guidoglorioso/StreamDeck-PCB/README.md

# StreamDeck-PCB
Proyecto de PCB para la materia de IDCI. El proyecto consta en una stream deck que da la posibilidad al usuario de crear shortcuts y macros personalizadas.
