guidoglorioso/StreamDeck-PCB/3d models/KEYCAP.STEP

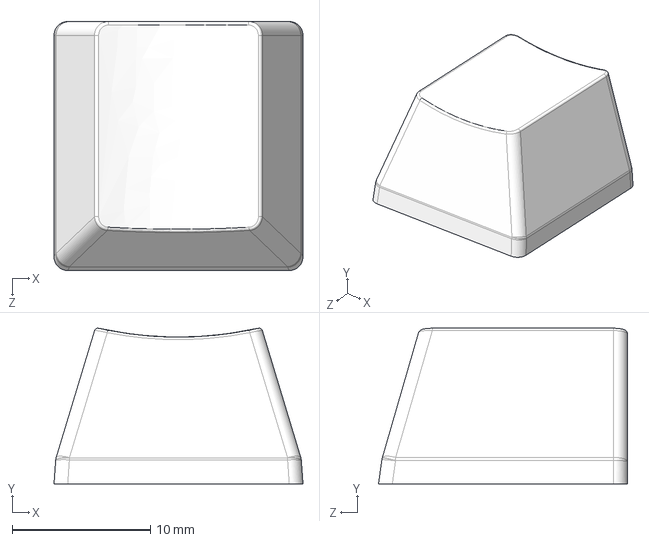
[picture p35: CAD file, 2024-10-15]
3d models/KEYCAP.STEP
18.0 x 11.3 x 18.0 mm
