guidoglorioso/StreamDeck-PCB/3d models/Volume Knob 32x13x6mm.STEP

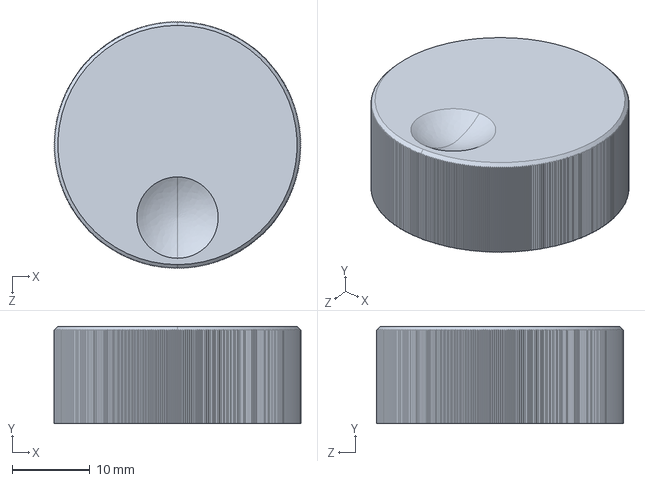
[picture p36: CAD file, 2024-10-15]
3d models/Volume Knob 32x13x6mm.STEP
31.8 x 12.5 x 31.8 mm
