guidoglorioso/StreamDeck-PCB/3d models/Bateria LiPo 3.7V.STEP

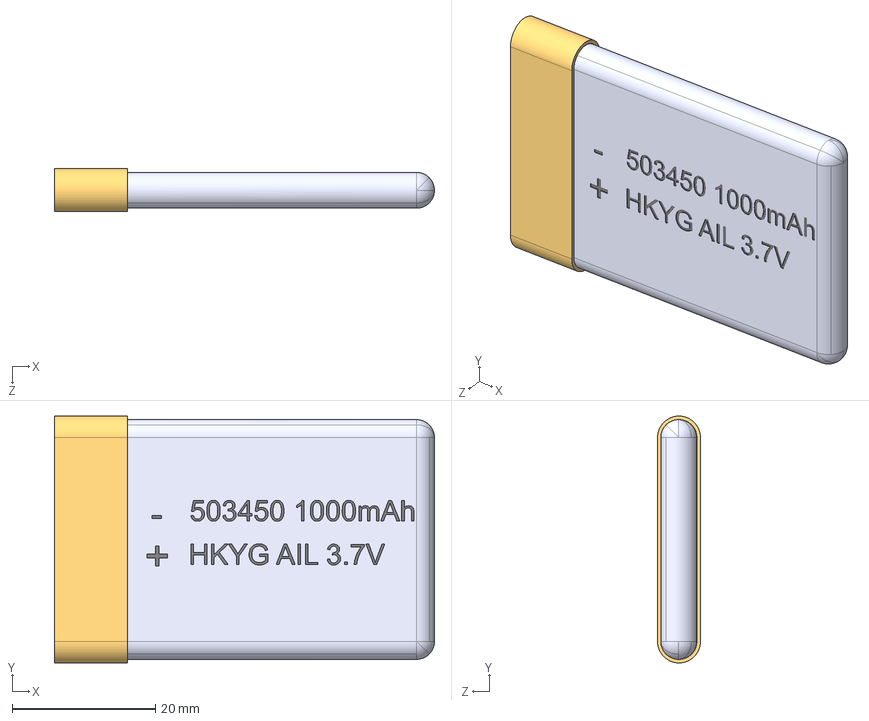
[picture p37: CAD file, 2024-10-08]
3d models/Bateria LiPo 3.7V.STEP
53.1 x 34.5 x 6.00 mm
parte de la pila_lipo.step
Bateria LiPo 3.7V 1000mA 503450.step
Bateria LiPo 3.7V 1000mA 503450-0.step
Bateria LiPo 3.7V 1000mA 503450-1.step
