guidoglorioso/StreamDeck-PCB/3d models/Kailh Polia.step

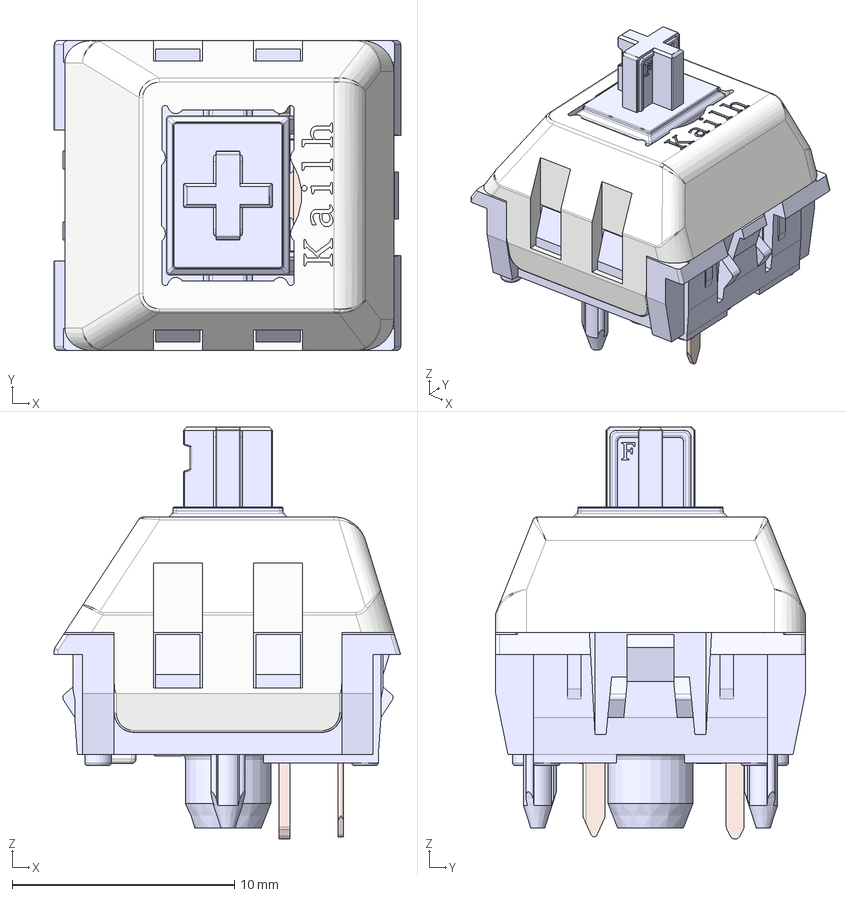
[picture p38: CAD file, 2024-10-08]
3d models/Kailh Polia.step
15.6 x 14.0 x 18.5 mm
Housing
ThickContact
SpringContact
Stem
Lid
