guidoglorioso/StreamDeck-PCB/3d models/EG2315.stp

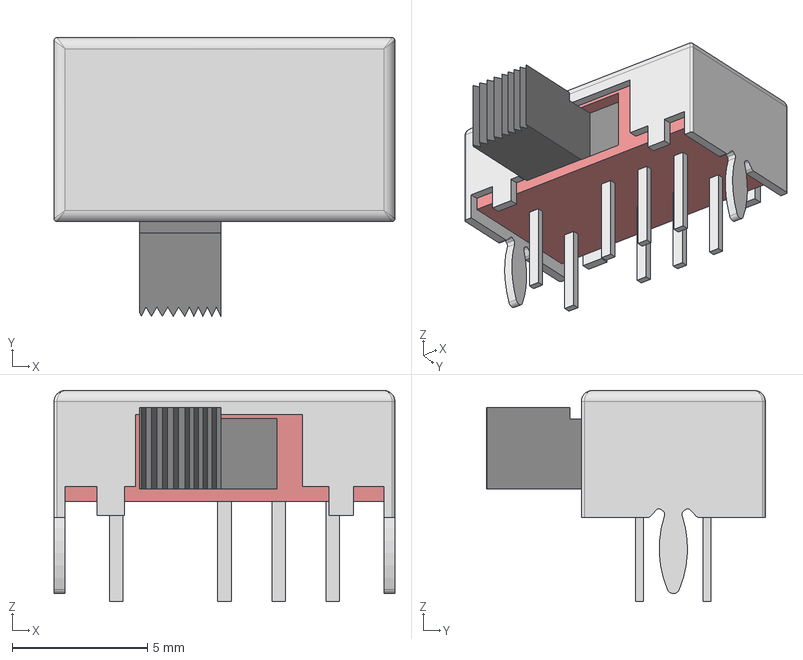
[picture p39: CAD file, 2024-10-08]
3d models/EG2315.stp
12.6 x 10.3 x 7.80 mm
