guidoglorioso/StreamDeck-PCB/3d models/ER-OLED0.91-3.STEP

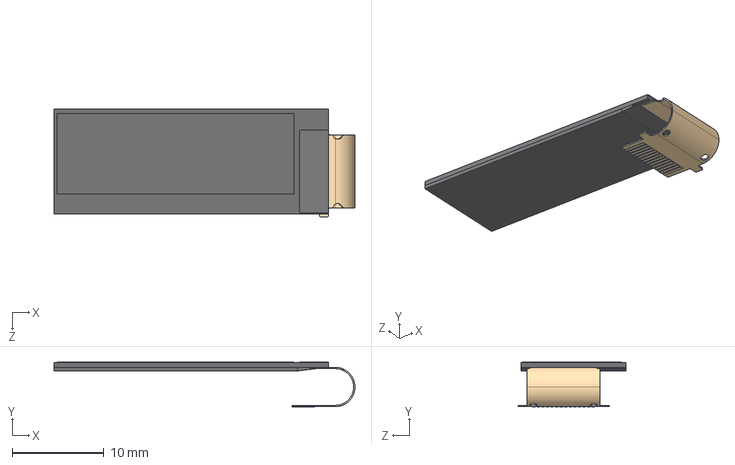
[picture p40: CAD file, 2024-10-08]
3d models/ER-OLED0.91-3.STEP
32.9 x 4.88 x 11.9 mm
