guidoglorioso/StreamDeck-PCB/Docs/SPEC-KS-9H10B045NN-Y51__Rev-1_KS-9_G_Red_Pro_3.0_Switch.pdf

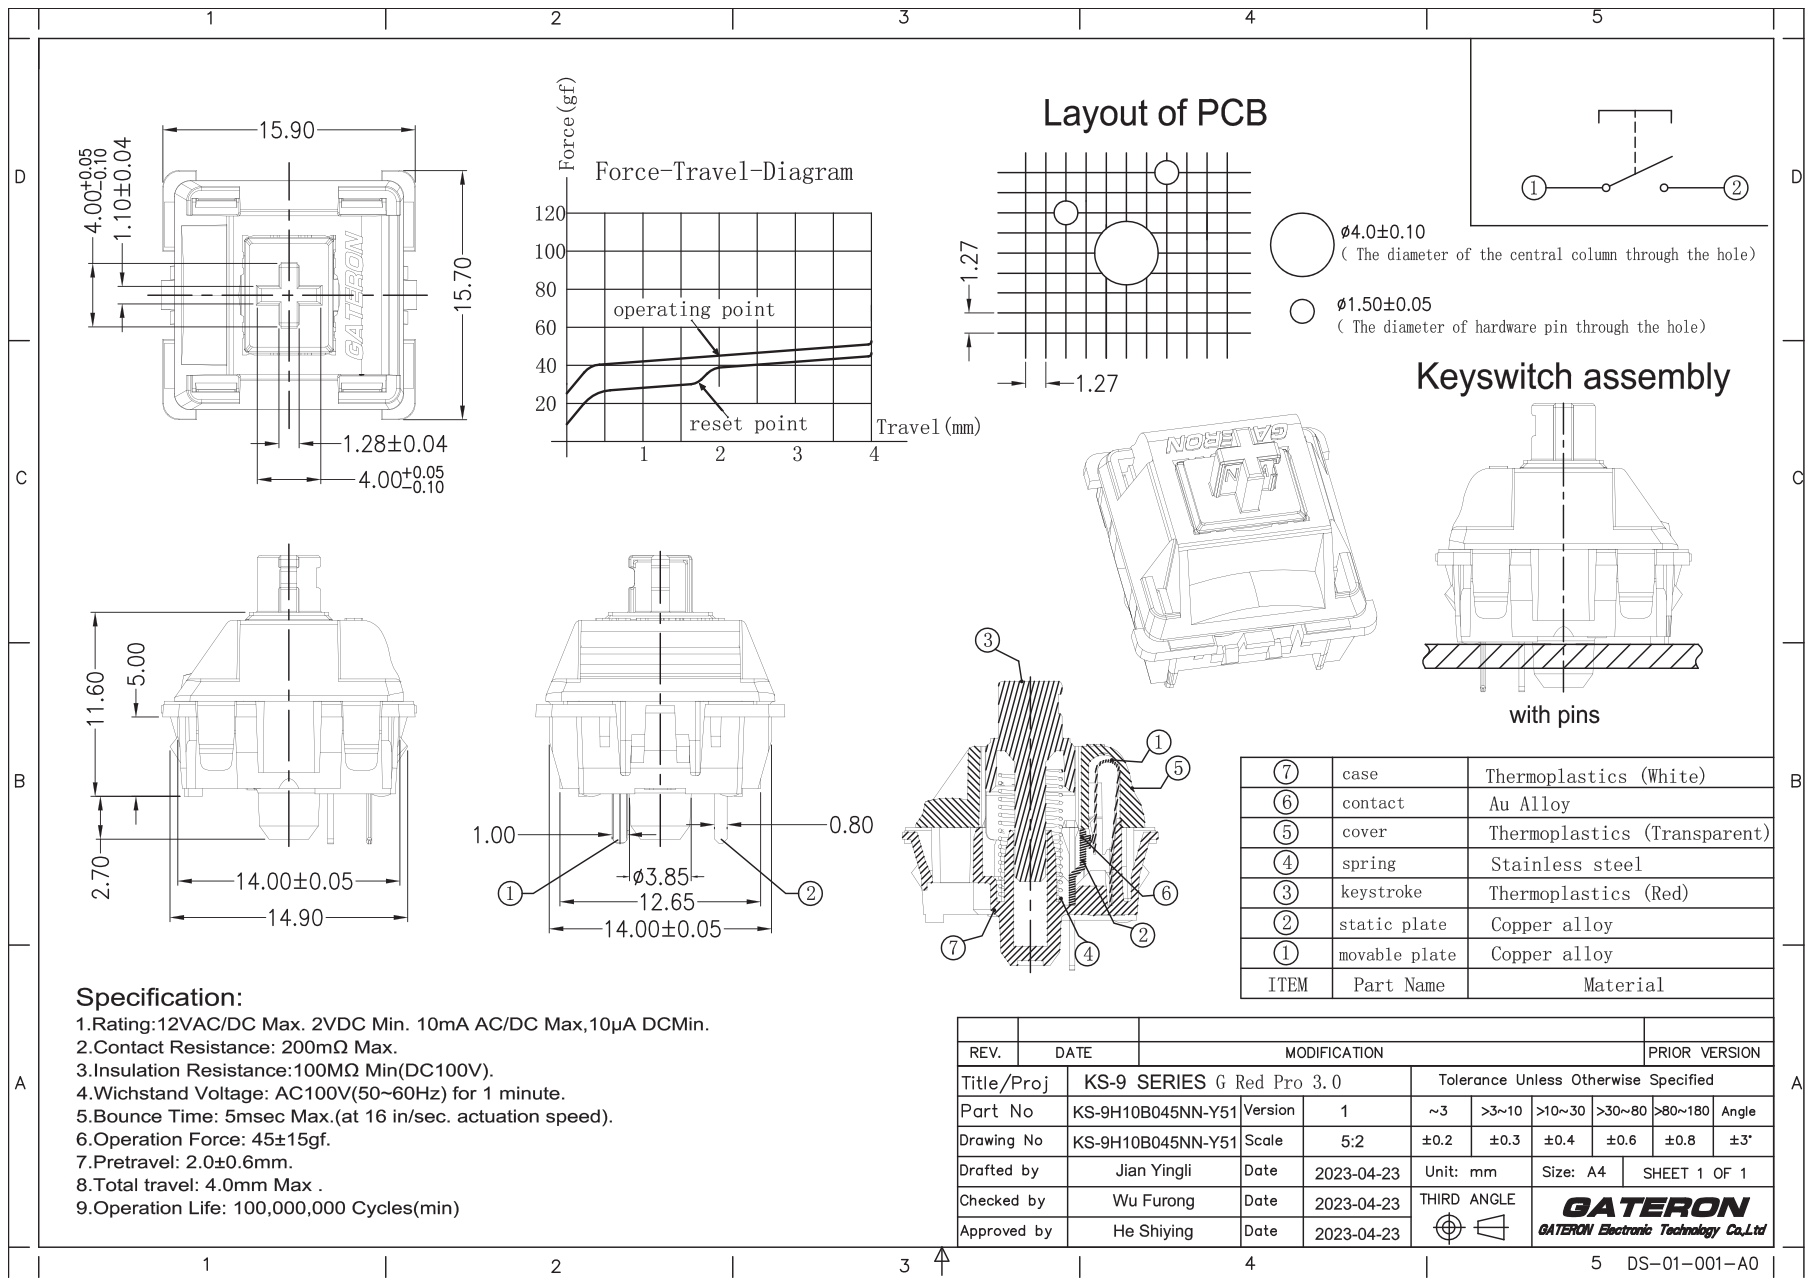
[picture p41: page 1]

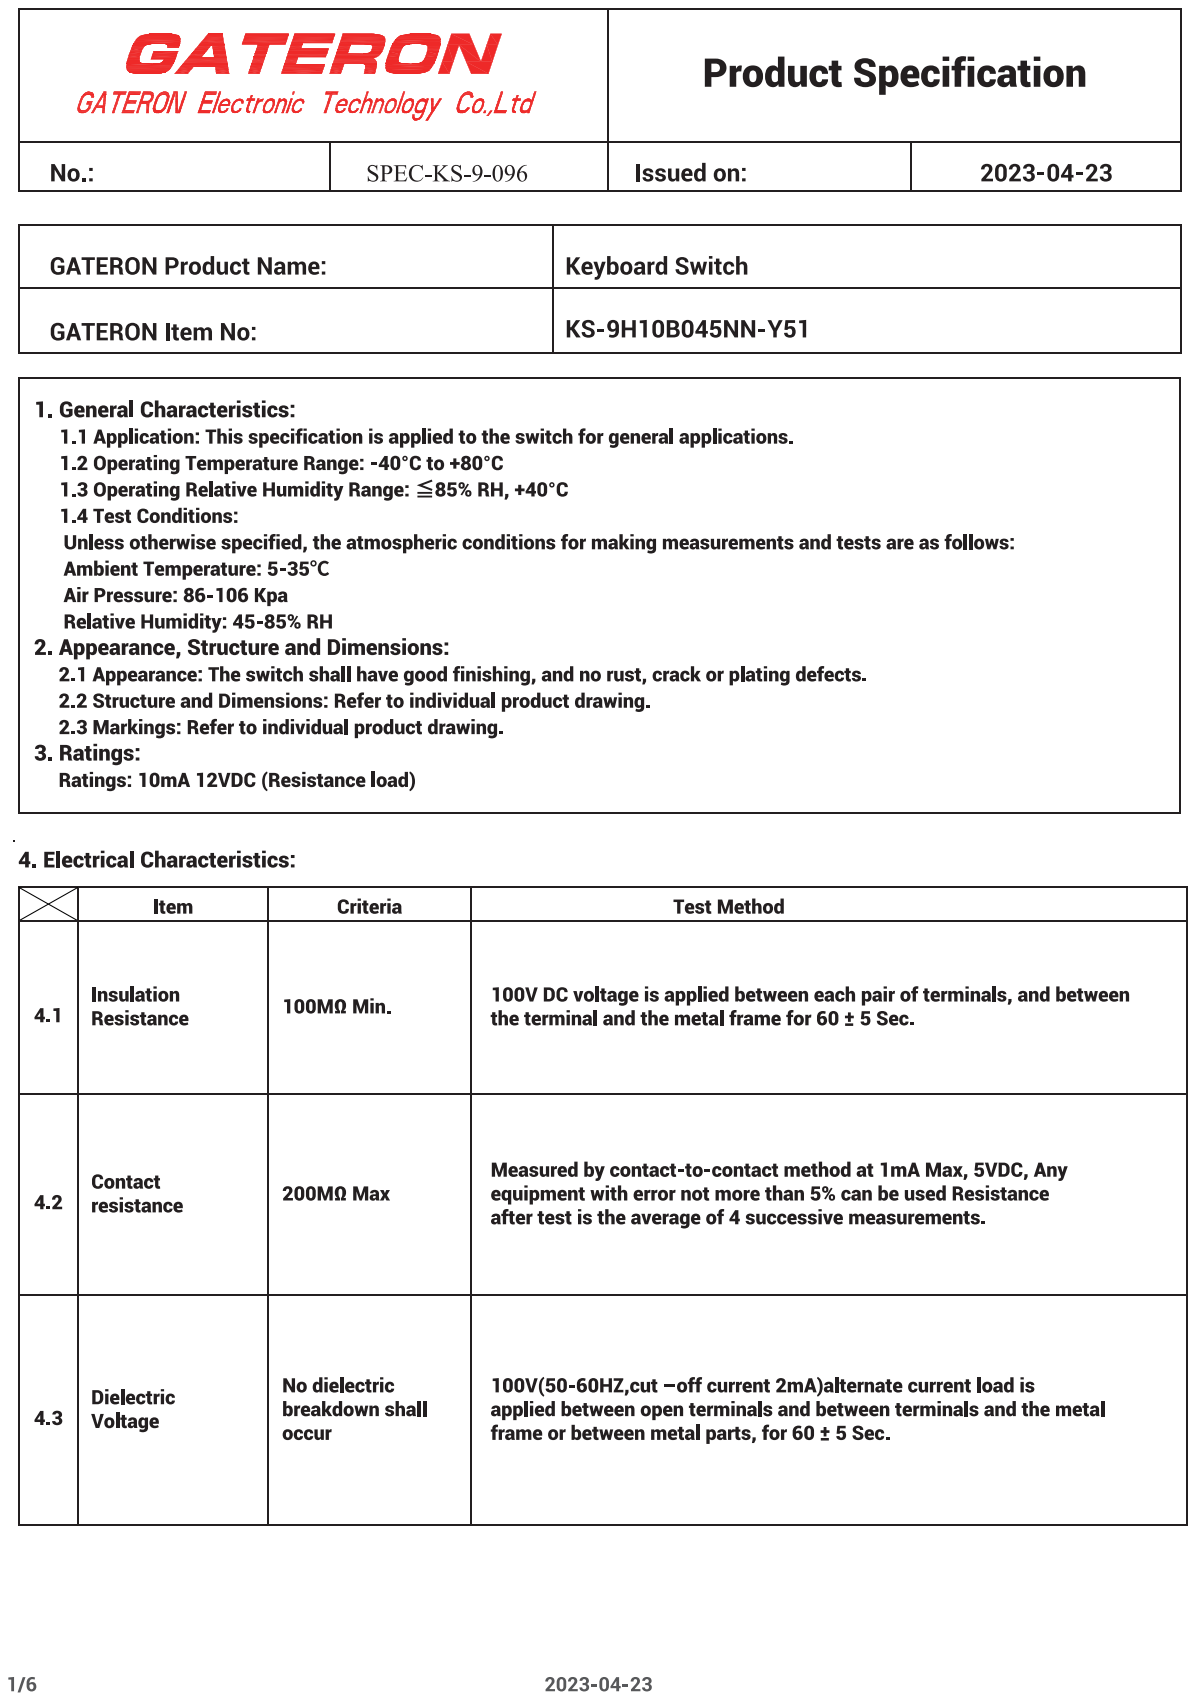
[picture p42: page 2]

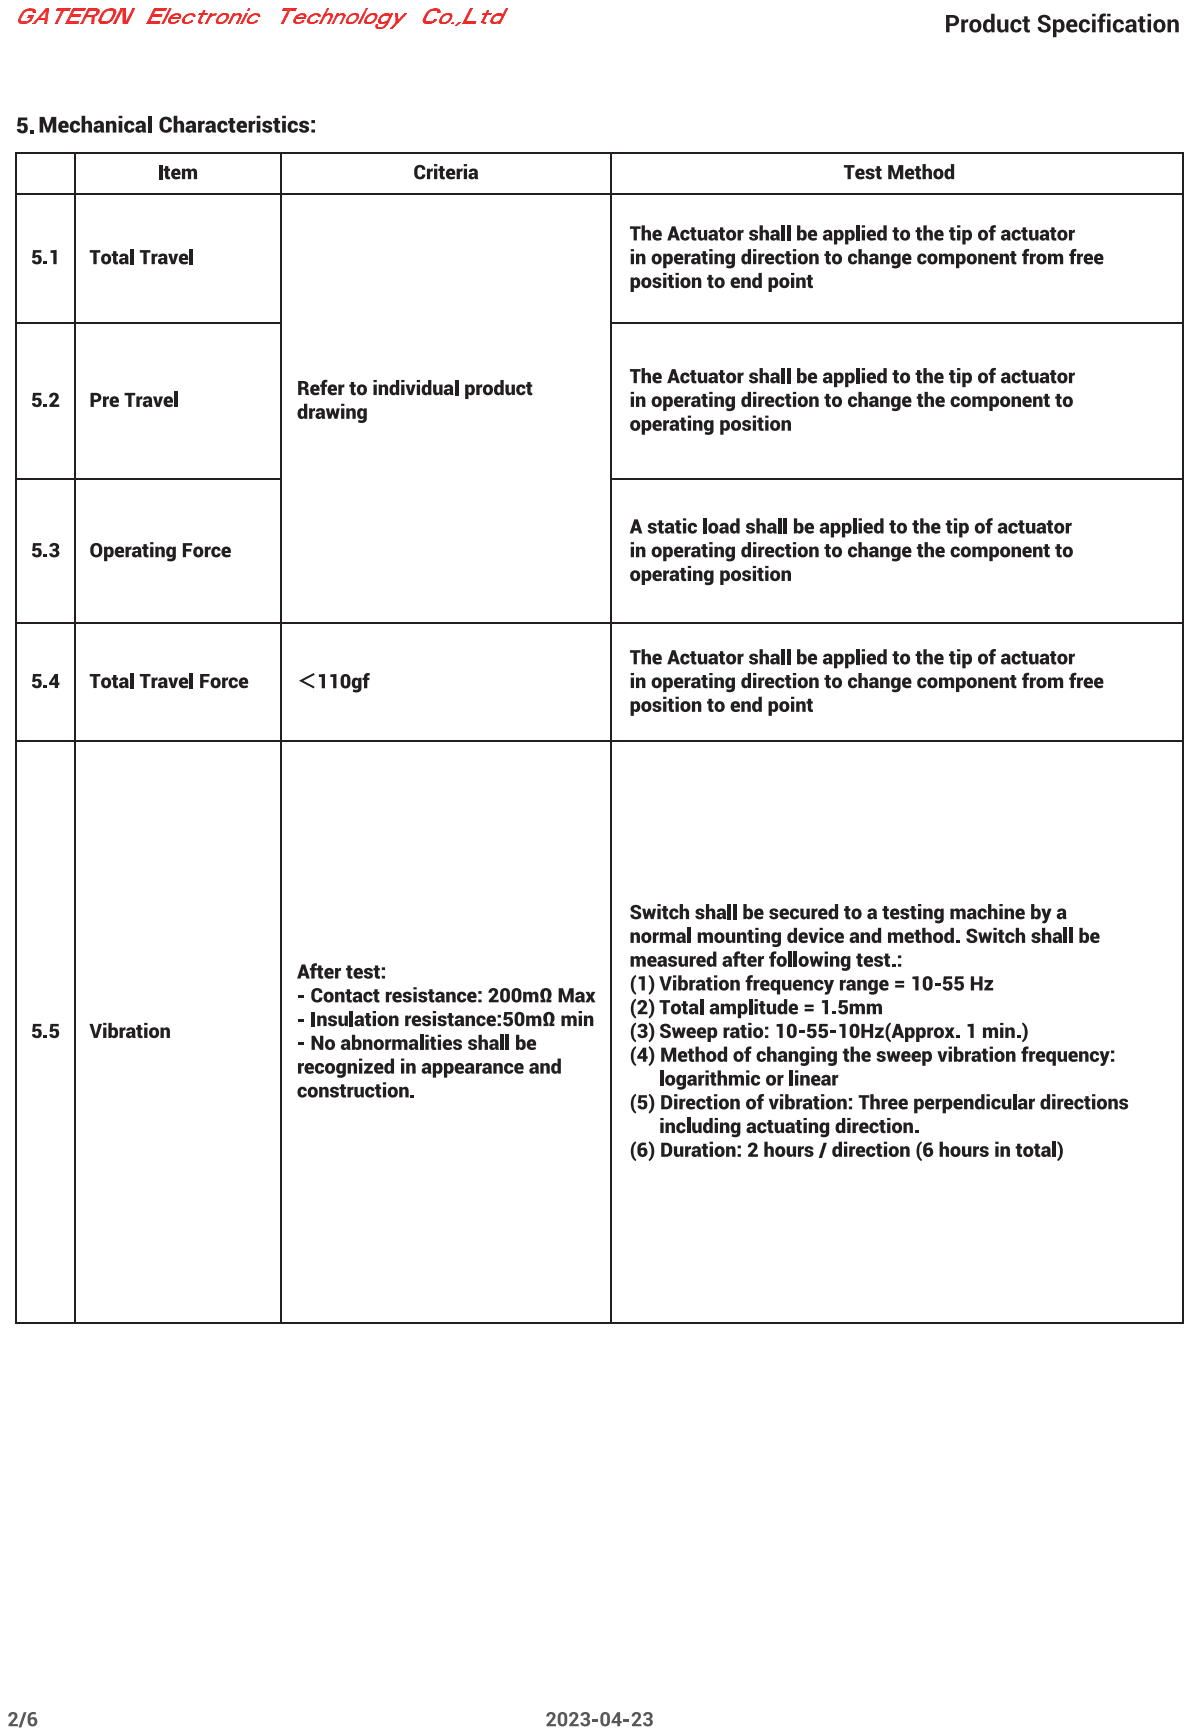
[picture p43: page 3]

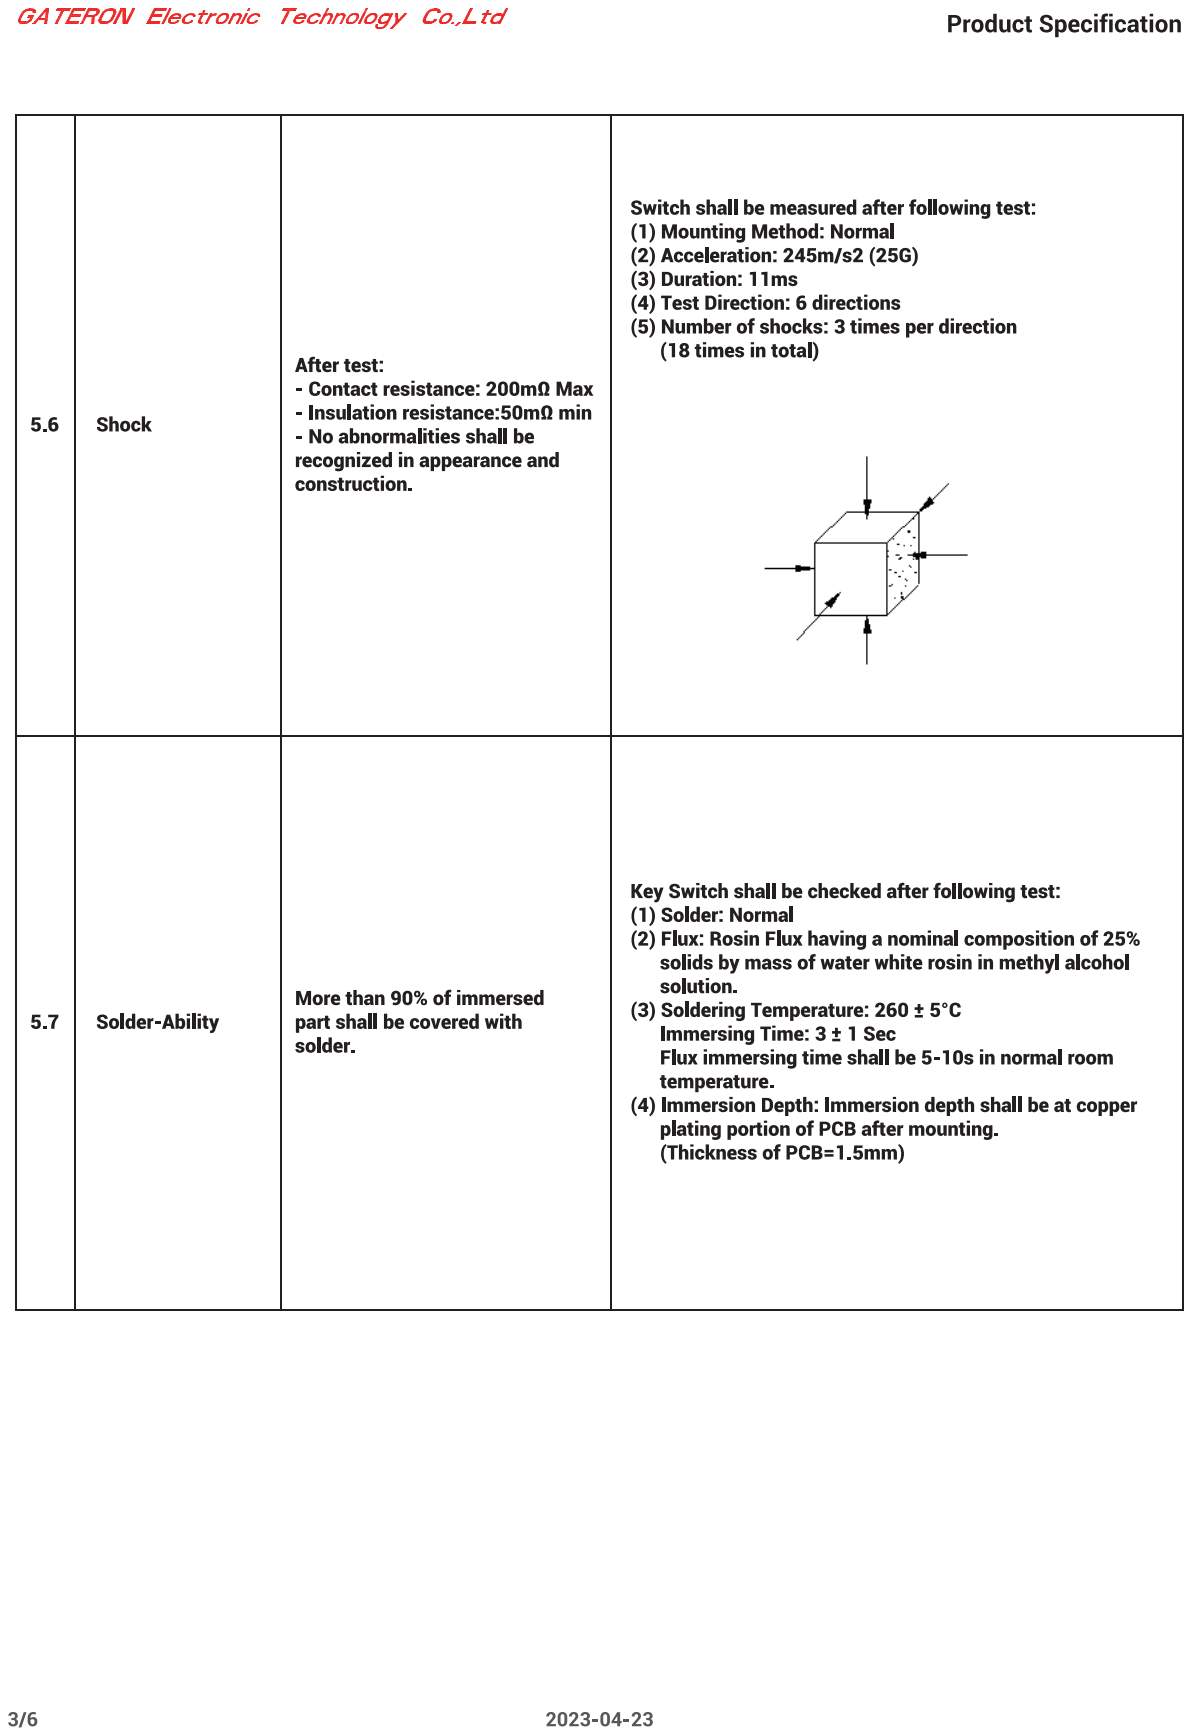
[picture p44: page 4]

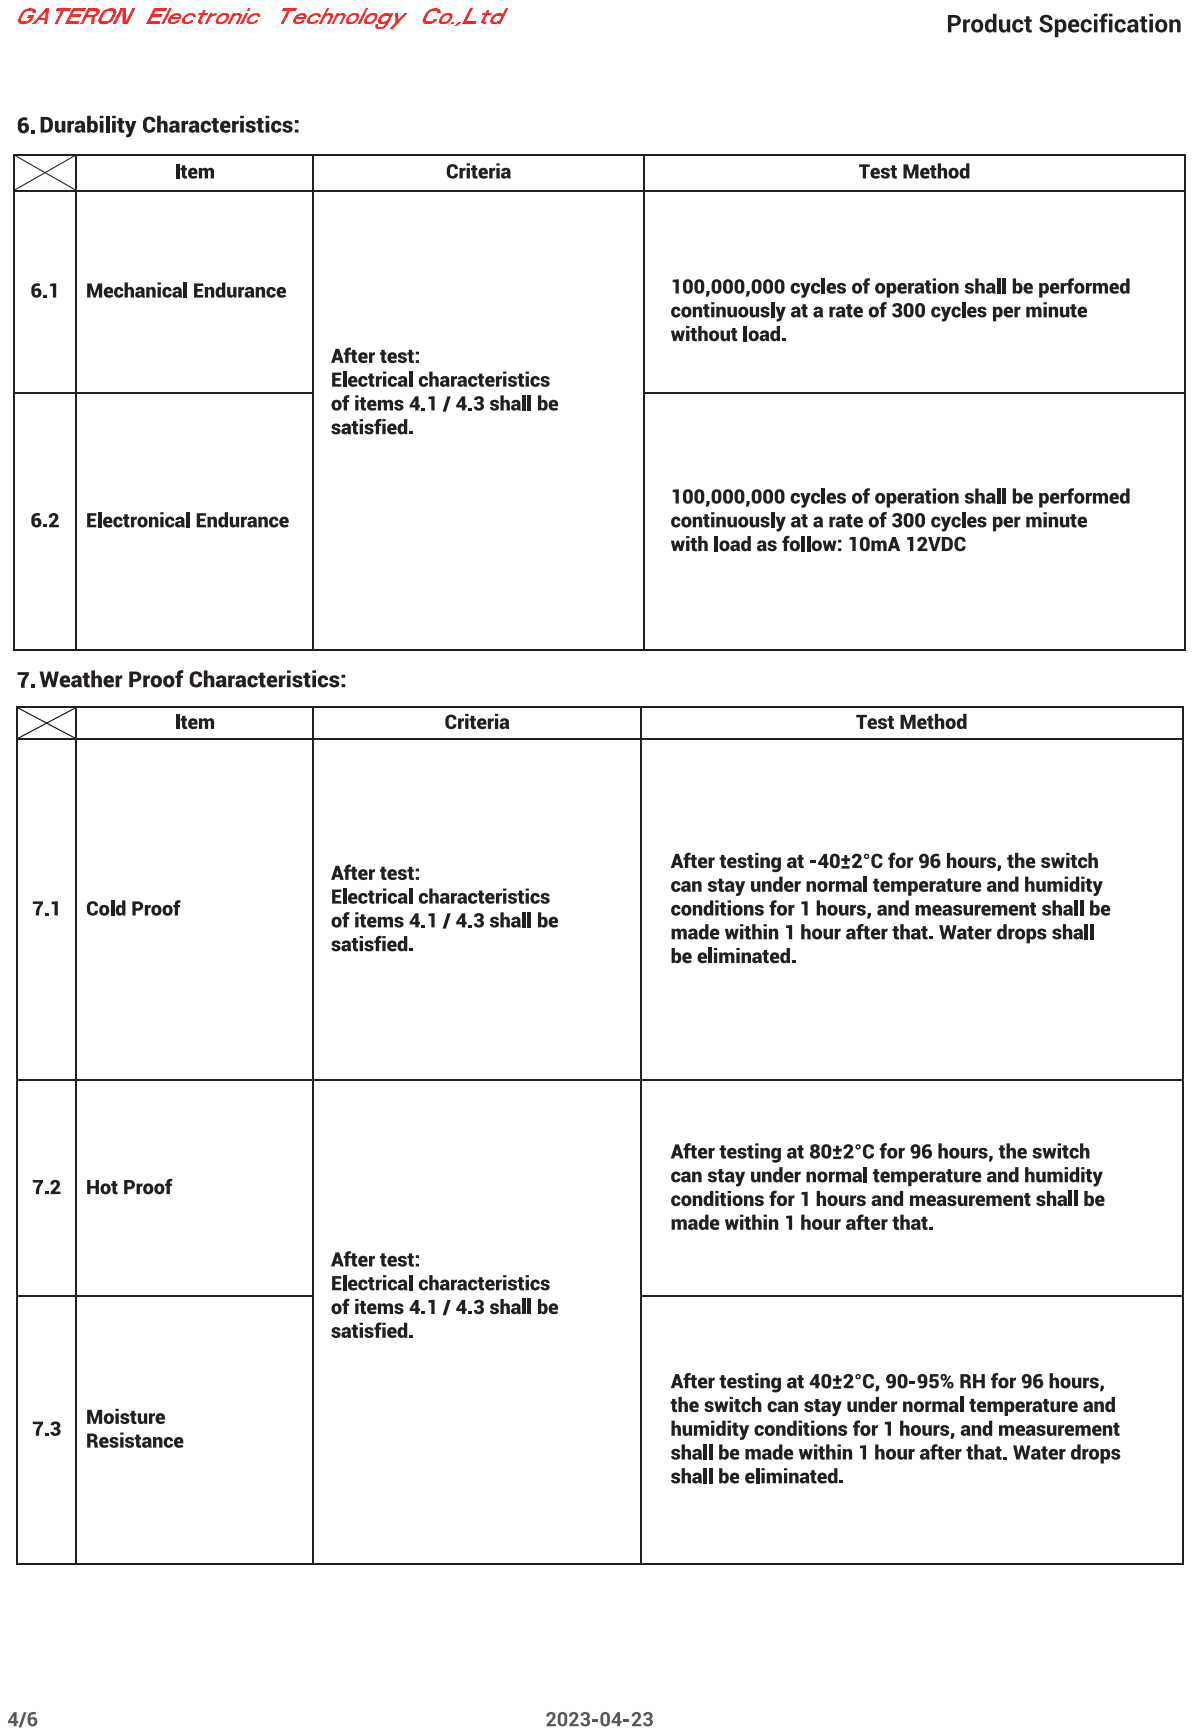
[picture p45: page 5]

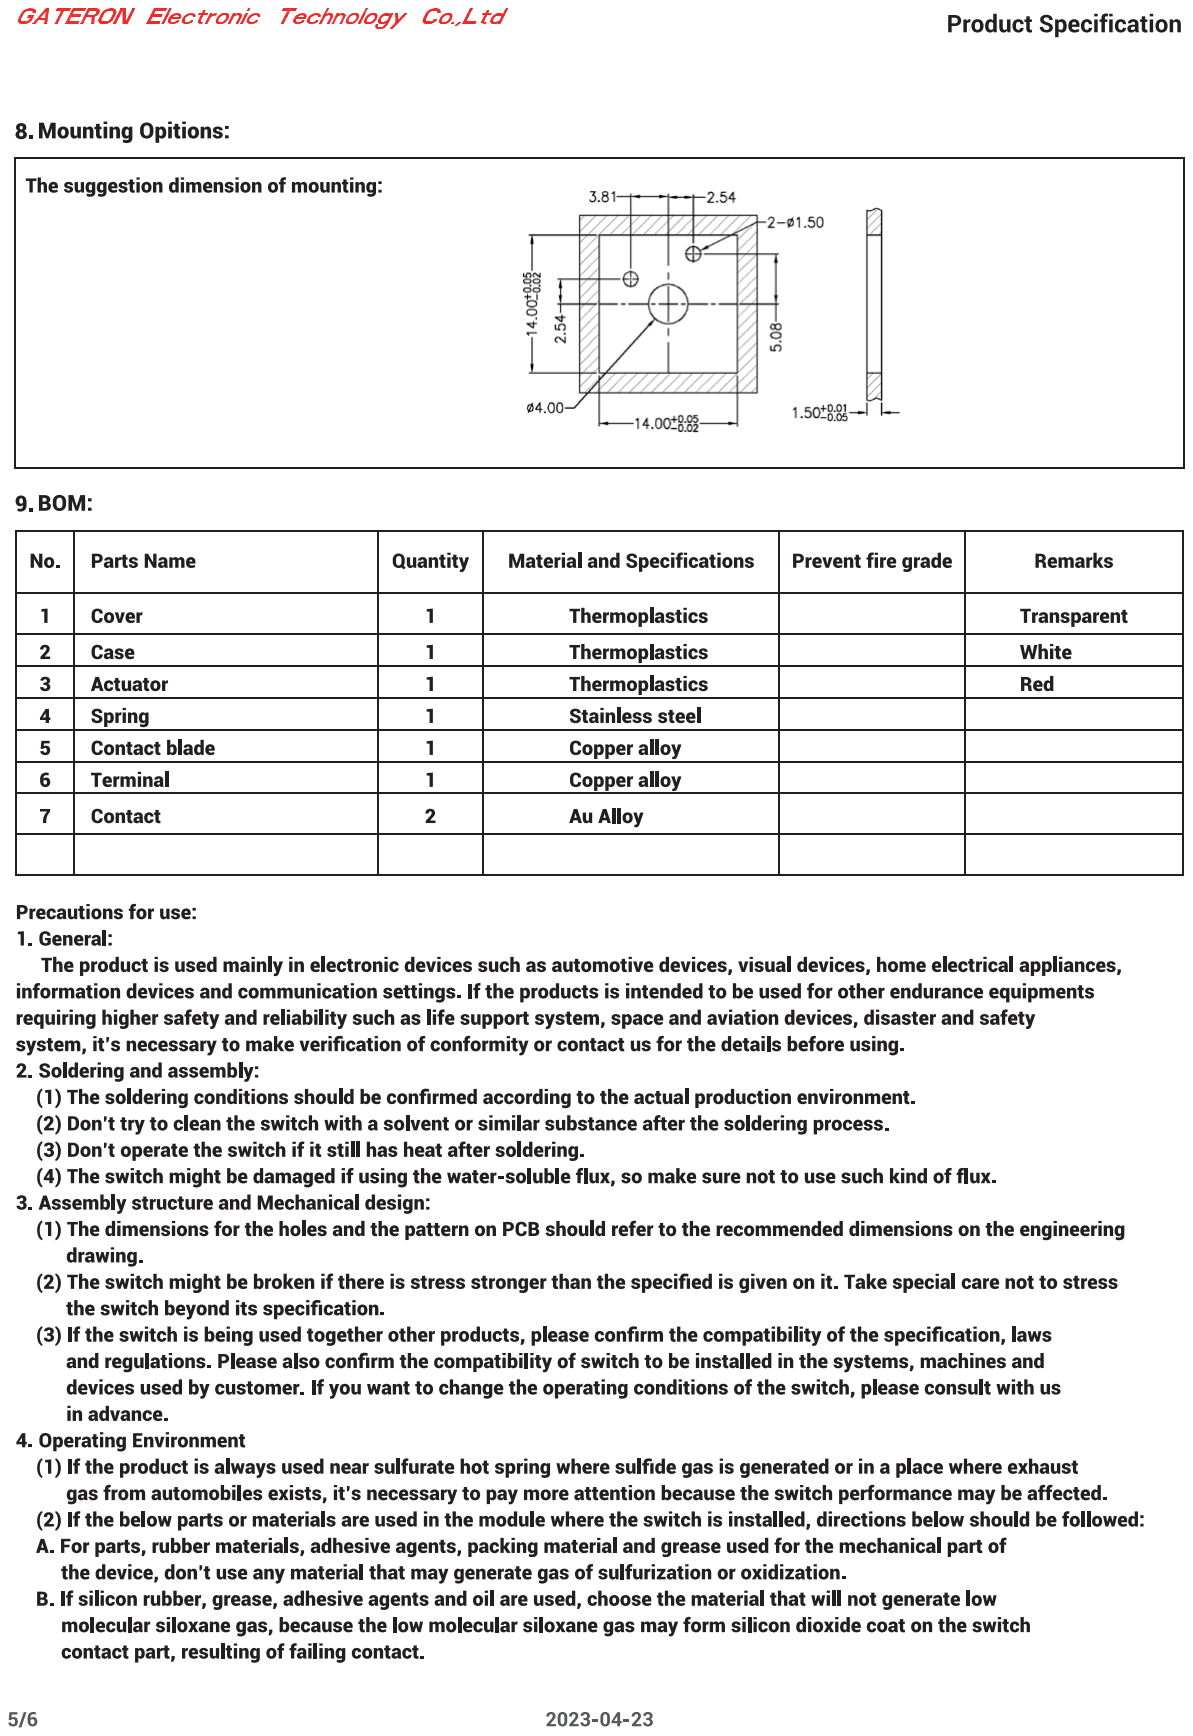
[picture p46: page 6]

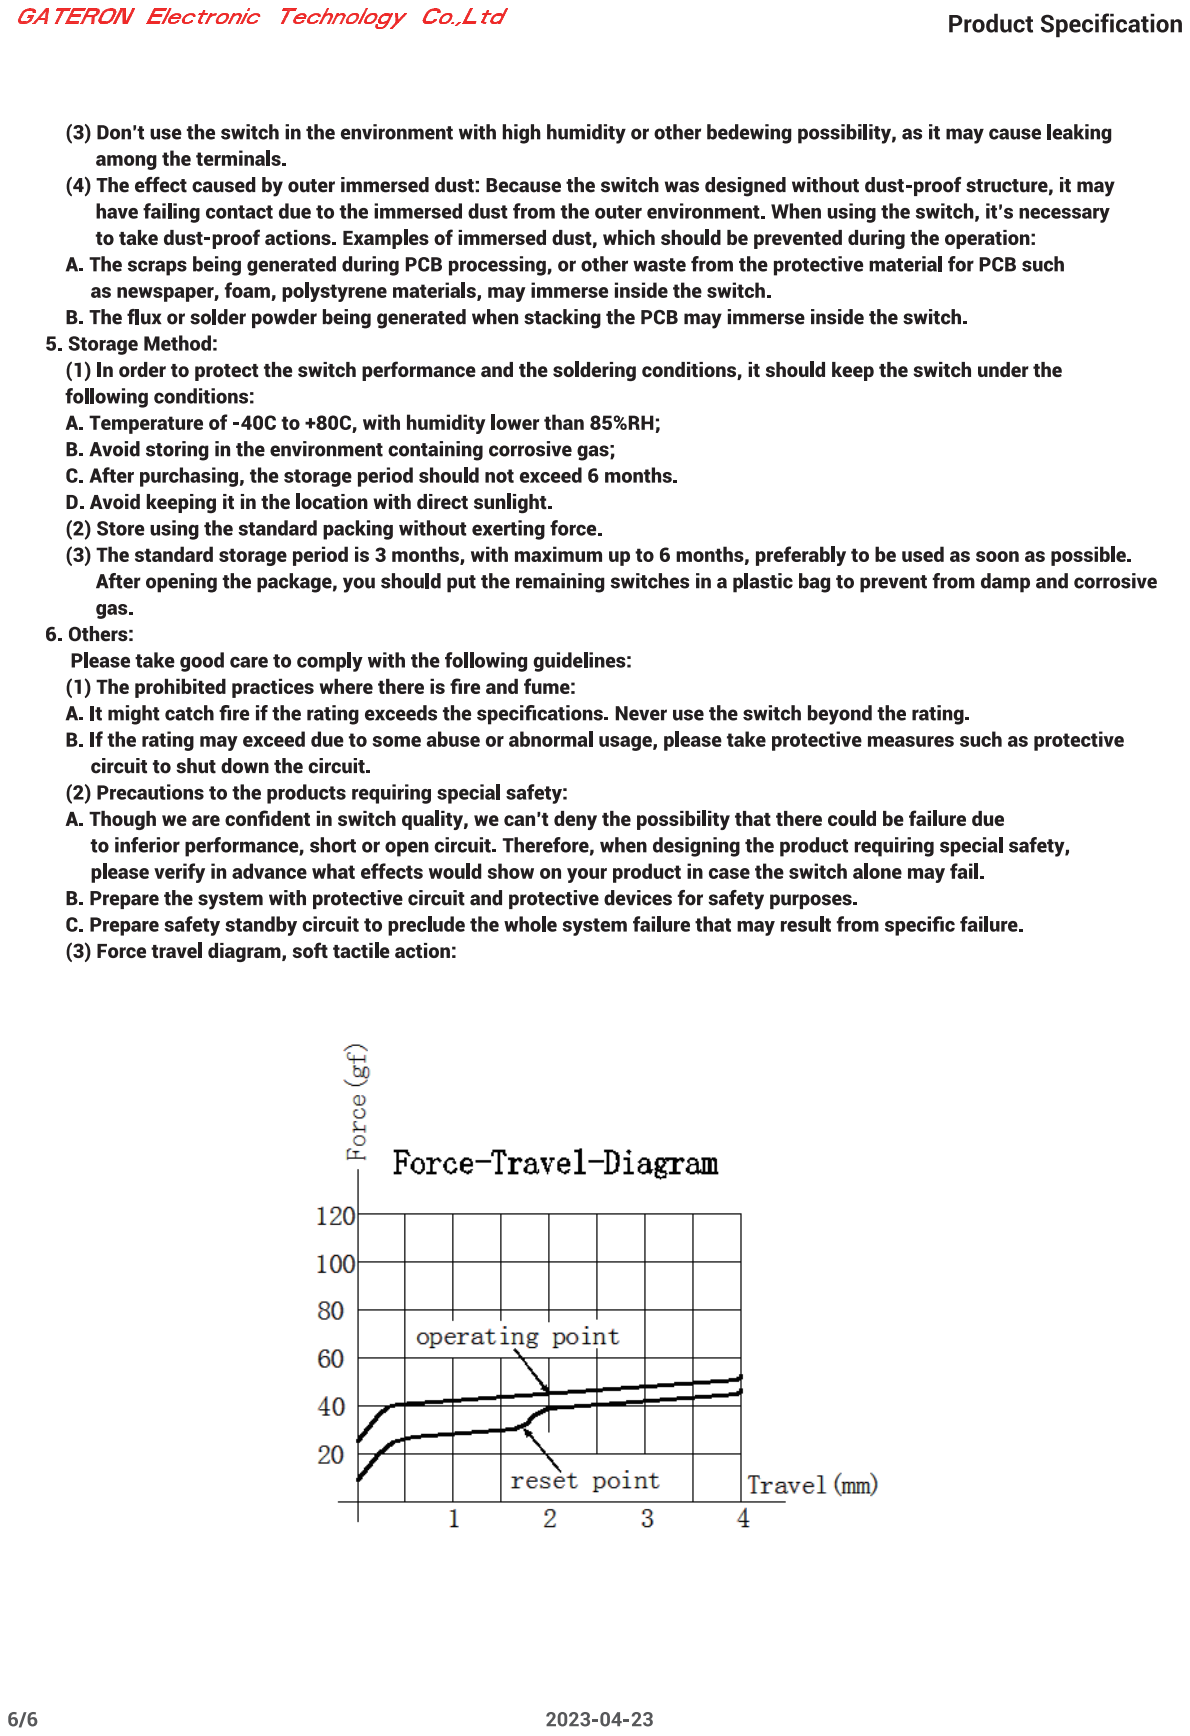
[picture p47: page 7]
