guidoglorioso/StreamDeck-PCB/(list of files, drawings)

Other design files:
Altium/Proyecto_IDCI-StreamDeck/Proyecto_IDCI-StreamDeck.PrjPcb
Altium/Proyecto_IDCI-StreamDeck/StreamDeck-V0.PcbLib
Altium/Proyecto_IDCI-StreamDeck/StreamDeck-V0.SchLib
Altium/Proyecto_IDCI-StreamDeck/StreamDeck_alimentacion-V0.SchDoc
Altium/Proyecto_IDCI-StreamDeck/StreamDeck_BLK-V0.SchDoc
Altium/Proyecto_IDCI-StreamDeck/StreamDeck_CPU1-V0.SchDoc
Altium/Proyecto_IDCI-StreamDeck/StreamDeck_CPU2-V0.SchDoc
Altium/Proyecto_IDCI-StreamDeck/StreamDeck_PANELIZADO.PcbDoc
Altium/Proyecto_IDCI-StreamDeck/StreamDeck_PCB-V0.PcbDoc
Altium/Proyecto_IDCI-StreamDeck/StreamDeck_Perifericos-V0.SchDoc
