guidoglorioso/StreamDeck-PCB/(commit log)

2024-10-06 Agrego libreria de esquematicos
    [Proyecto_IDCI-StreamDeck.PrjPcb, StreamDeck-V0.PcbLib, StreamDeck-V0.SchLib, StreamDeck_alimentacion-V0.SchDoc]
2024-10-06 Agrego esquematicos y correccion de errores
    [Proyecto_IDCI-StreamDeck.PrjPcb, StreamDeck-V0.SchLib, StreamDeck_BLK-V0.SchDoc, StreamDeck_CPU1-V0.SchDoc, StreamDeck_CPU2-V0.SchDoc, StreamDeck_Perifericos-V0.SchDoc, StreamDeck_alimentacion-V0.SchDoc]
2024-10-07 Agrego Footprints y retoques de esquematicos
    [Proyecto_IDCI-StreamDeck.PrjPcb, StreamDeck-V0.PcbLib, StreamDeck-V0.SchLib, StreamDeck_BLK-V0.SchDoc, StreamDeck_CPU1-V0.SchDoc, StreamDeck_CPU2-V0.SchDoc, StreamDeck_PCB-V0.PcbDoc, StreamDeck_Perifericos-V0.SchDoc]
2024-10-08 Librerias terminadas con footprints y 3D
    [Bateria LiPo 3.7V.STEP, EG2315.stp, ER-OLED0.91-3.STEP, Kailh Polia.step, StreamDeck-V0.PcbLib, StreamDeck-V0.SchLib, StreamDeck_PCB-V0.PcbDoc, StreamDeck_Perifericos-V0.SchDoc]
2024-10-15 Ordeno componentes pcb
    [KEYCAP.STEP, Proyecto_IDCI-StreamDeck.PrjPcb, StreamDeck-V0.SchLib, StreamDeck_BLK-V0.SchDoc, StreamDeck_CPU1-V0.SchDoc, StreamDeck_CPU2-V0.SchDoc, StreamDeck_Perifericos-V0.SchDoc, StreamDeck_alimentacion-V0.SchDoc]
2024-12-02 Agrego version STM32F401Re
    [Proyecto_IDCI-StreamDeck.PrjPcb, StreamDeck-V0.SchLib, StreamDeck_PANELIZADO.PcbDoc, StreamDeck_Perifericos-V0.SchDoc, StreamDeck_alimentacion-V0.SchDoc]
2024-12-02 PCB V1.0 - Panelizado - Archivos de fabricacion
    [Proyecto_IDCI-StreamDeck.PrjPcb, StreamDeck-V0.SchLib, StreamDeck_PANELIZADO.PcbDoc, StreamDeck_Perifericos-V0.SchDoc, StreamDeck_alimentacion-V0.SchDoc]
2024-12-19 Se corrigen detalles, se agrega informe
    [Proyecto_IDCI-StreamDeck.PrjPcb, StreamDeck-V0.SchLib, StreamDeck_CPU1-V0.SchDoc, StreamDeck_CPU2-V0.SchDoc, StreamDeck_alimentacion-V0.SchDoc]
2024-12-19 Detalles extras
    [StreamDeck_CPU2-V0.SchDoc]
